shanshannnnnn/smart-irrigation-controller/soil_moisture_monitor/profile.h

/* This header file contains macros for use with the #ifdef ( or #if defined)...#else... #endif directives in C
   for conditional compilations
   see https://gcc.gnu.org/onlinedocs/cpp/Ifdef.html
*/
    #define Publish             // uncomment to enable publish
    #define Subscribe           // uncomment to enable subscribe




/*** For Secure TLS/MQTTS, use with certificates in cert.h ***/
    //#define HIVEMQS            // HIVEMQ Secure
                                 // OR
    //#define MOSQUITTOS         // MOSQUITTO Secure
