shanshannnnnn/smart-irrigation-controller/(commit log)

2026-08-25 ESP32 soil moisture monitoring and irrigation system
    End-to-end IoT system: capacitive soil probe read and calibrated on an
    ESP32, classified into dry/normal/wet with local LED and buzzer indication,
    telemetry published over MQTT, and a relay-driven pump actuated from the
    cloud side.
    Cloud: Node-RED parses and logs readings to InfluxDB, applies threshold
    logic, and publishes downlink commands. Grafana renders the dashboard.
    Hardware designed in KiCad, including an MCP6022 comparator stage with an
    adjustable trip point.
    Credentials are templated as credentials.example.h and gitignored; the
    Node-RED export is sanitized of broker and database details.
    [cert.example.h, credentials.example.h, parameters.h, profile.h, soil_moisture_monitor.ino]
2026-08-25 Prepare for public release: remove personal identifiers
    Replace the MQTT client id with a generic placeholder in firmware, Node-RED
    exports and documentation. On a public broker the client id is enough to
    address the device's downlink topic, so publishing it alongside the topic
    convention would let anyone command the hardware.
    Also redact the client id from dashboard and serial-log screenshots, remove
    course codes and personal identifiers, and crop browser chrome exposing a
    personal cloud instance URL.
    [parameters.h, soil_moisture_monitor.ino]
